taciturnaxolotl/doomacracy/linux/README.md

# Linux on doomacracy

A no-MMU Linux 6.8 (cnlohr's mini-rv32ima fork) with busybox in an
initramfs, configured for the DE1's 8 MB of SDRAM.

## Build (on a Linux machine)

```
cd linux
nix-build fhs.nix -o br-fhs      # NixOS only: a normal /usr layout for buildroot
./br-fhs/bin/br-fhs -c ./build.sh
```

The first build makes a cross toolchain and takes about an hour on two
cores. Copy `work/buildroot/output/images/Image` to `build/linux-Image`.

## Run in the emulator

```
make linux-emu            # 8 MB, the board's real size
```

## Changes from cnlohr's configs

- `CONFIG_RISCV_MISALIGNED=y`: our CPU traps on misaligned loads and stores
  (cnlohr's emulator quietly handles them), so the kernel has to fix them up.
- busybox: `FEATURE_PREFER_APPLETS` and `FEATURE_SH_STANDALONE`, so hush runs
  simple applets in-process; `vi` turned on; a few applets dropped (unzip,
  top, tree, lsof, checksums, xxd, and login/getty, which pulled in 83 KB of
  password code nothing here uses). No-MMU loads a private copy of busybox
  for every process, rounded up to a power of two, so its load size (text +
  data + bss + stack, from `flthdr`) has to stay under 512 KB; it is 430 KB.
- `patches/uclibc/0001-riscv32-no-64bit-syscall-arg-alignment.patch`: uClibc
  padded 64-bit syscall arguments ARM-style on riscv32, so `ftruncate`
  received a length of 0 and `vi` emptied every file it saved.
- `overlay/etc/inittab`: a respawning root shell on the serial console and
  one on the screen (`tty1`).
- Framebuffer console: `FB_SIMPLE`, `FRAMEBUFFER_CONSOLE`, `FONT_6x8`.
- Keyboard: `SERIO_ALTERA_PS2`, `KEYBOARD_ATKBD`, and the PLIC driver.
- `patches/linux/0001-altera_ps2-receive-only.patch`: the board's PS/2 port
  only receives, so the driver registers no write function; `atkbd` then
  skips probing the keyboard and treats it as plain set 2. The patch
  directory is listed after cnlohr's own (`board/qemu/riscv32-virt/nommu/
  patches`), which carries the rv32 no-MMU support; replacing it instead of
  adding to it builds a kernel whose `wait4` returns ENOSYS.
- The kernel's built-in device tree is not used; `tools/gen_dts.py` writes it.

## doomfetch

`doomfetch/doomfetch.c` is a small neofetch, compiled into the image by
`post-build.sh` and run from `/etc/profile` when a shell starts. It is C on
purpose: every process here loads its own copy of its program, so a 64 KB
binary is far cheaper than a script that runs busybox (430 KB) a dozen
times. For the same reason a pipe of two external busybox commands can run
out of memory; prefer shell builtins where you can.

Programs of your own are built the same way: the buildroot cross gcc with
`-fPIC -Wl,-elf2flt="-r -s STACK"`, and delete the `.gdb` file elf2flt
leaves next to the binary.

## doombench

`doombench` (`-q` for a quicker run) times a set of small tests and prints,
for each, the wall time, a rate, and the real cycles per instruction from
the CPU's own `cycle` and `instret` counters: integer ALU, multiply, divide,
`qsort`, reads and writes inside the D-cache (4K) and well beyond it (128K),
`memcpy`, load latency for a dependent pointer chase (cycles per hop,
including the loop), a system call, and starting a process. The last line
checks the cycle counter against the wall clock (it should read 50 MHz).
The table fits the 53x25 screen, since there is no pager.

In the emulator with `--timing --icache-bits 9 --dcache-bits 9` the same
table comes from the RTL cycle model, so the two can be compared row by row.
Measured on the DE1 (the cycle counter read 50.0 MHz) against the model:

| test | board ms | board rate | board CPI | model ms | model CPI |
| --- | --- | --- | --- | --- | --- |
| alu | 579 | 20.74 Mop/s | 1.43 | 573 | 1.42 |
| mul | 125 | 4.02 M/s | 2.44 | 123 | 2.41 |
| div | 161 | 1.24 M/s | 9.35 | 160 | 9.24 |
| qsort 1K | 177 | 69.24 Kel/s | 1.45 | 175 | 1.43 |
| read 4K | 152 | 52.57 MB/s | 1.30 | 152 | 1.30 |
| read 128K | 319 | 25.04 MB/s | 2.71 | 315 | 2.67 |
| write 4K | 178 | 45.05 MB/s | 2.37 | 174 | 2.31 |
| write 128K | 177 | 45.08 MB/s | 2.37 | 173 | 2.31 |
| memcpy 64K | 233 | 17.15 MB/s | 2.36 | 225 | 2.27 |
| lat 4K | 41 | 207 ns | 10.3 cyc | 41 | 10.3 cyc |
| lat 128K | 108 | 541 ns | 27.0 cyc | 119 | 29.7 cyc |
| syscall | 186 | 107.53 K/s | 1.83 | 184 | 1.81 |
| spawn | 108 | 73.96 /s | 4.33 | 94 | 3.41 |

Eleven of the thirteen rows agree within 4%. The two that do not are
`lat 128K` (the board is 9% faster) and `spawn` (the board is 27% slower).
The likely reason, not yet checked, is that both depend on where things land
in SDRAM: in `lat 128K` every load misses the cache, so the cost is which
rows happen to be open, and `spawn` depends on where the kernel finds room
for the new process.
