taciturnaxolotl/doomacracy/(commit log)

2026-11-11 feat: boot a no-MMU Linux to a shell on the soft CPU
    The CPU gains what Linux needs: control registers, traps and interrupts,
    machine and user mode, atomics and an instruction-cache flush. New
    devices add a timer, a 16550 serial console that also runs over the
    USB-Blaster, and power-off/reboot. The boot ROM can now load a Linux
    image (kernel plus device tree) from flash, and linux/ holds a buildroot
    recipe for a kernel and busybox that fit in the DE1's 8 MB. Doom is
    unchanged and still matches its reference trace.
    💘 Generated with Crush
    Assisted-by: Crush:claude-opus-5-5
    [boot.c, cpu.vhd, dcache.vhd, doomacracy.vhd, doomacracy_emu.c]
2026-11-11 feat: show the Linux console on the VGA monitor
    The video hardware gains a 16-bit colour mode, which Linux's simple
    framebuffer driver needs. The boot ROM switches to it before starting the
    kernel, and the kernel now runs a text console and a shell on the screen
    alongside the serial console. Doom still uses the 256-colour mode and is
    unaffected.
    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
2026-11-11 feat: type into Linux on the board's PS/2 keyboard
    Adds a PS/2 receive port that Linux's existing Altera PS/2 driver can
    use and a minimal standard interrupt controller to deliver its
    interrupts, so the shell on the VGA console takes keyboard input and
    the board works without a PC. The keyboard port can't send commands,
    so a small kernel patch makes the driver skip probing the keyboard.
    Doom is unchanged.
    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
    [cpu.vhd, doomacracy.vhd, doomacracy_emu.c, io.vhd, tb_cpu.vhd]
2026-11-12 feat: add the vi text editor to Linux on the board
    Busybox's vi is now included, and it saves files correctly: uClibc
    passed 64-bit system call arguments with ARM-style padding on 32-bit
    RISC-V, so the kernel saw a length of zero and every save emptied the
    file. A uClibc patch fixes that for all such calls. Busybox drops its
    unused login and getty to stay small enough for the 8 MB of memory, and
    the emulator no longer drops scripted keystrokes when idle time jumps.
    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
    [doomacracy_emu.c]
2026-11-12 feat: add doomfetch, a neofetch for the board
    A small C program shows a skull, the hardware, kernel, uptime, memory
    and a colour bar whenever a shell starts, sized for the 53-column screen
    console. It is built into the Linux image during the buildroot build and
    kept tiny because every process on this machine loads its own copy of
    its program.
    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
2026-11-12 perf: keep SDRAM rows open between accesses
    The SDRAM controller used to open a row, read or write, and close it
    again for every access. It now leaves one row open per bank, so accesses
    to a row that is already open skip that overhead and writes finish as
    soon as their data is out. By the emulator's cycle model this makes
    Linux about 25% faster and Doom about 3%. The simulated SDRAM chip now
    checks per-bank row timing, so a timing mistake in the controller fails
    the tests.
    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
    [doomacracy_emu.c, models.vhd, sdram_ctrl.vhd]
2026-11-13 fix: stop KEY0 resets from corrupting SDRAM
    Since SDRAM rows stay open between accesses, pressing KEY0 reset the
    controller's record of open rows but left them open in the chip. After
    that, refreshes and row opens were refused, so data in SDRAM could be
    lost or written to the wrong place. The flash loader buffers images in
    SDRAM, so loads started with KEY0 sometimes wrote garbage to flash and
    the board then failed to boot, while a full power cycle worked. The
    controller now closes every bank after a reset, a new simulation test
    presses KEY0 in the middle of an SDRAM test, and the loader re-reads
    its buffer before writing flash so memory faults stop the load.
    Assis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
    [boot.c, sdram_ctrl.vhd, tb_soc.vhd]
2026-11-13 feat: add doombench to measure the board from inside Linux
    A small benchmark times integer, multiply and divide work, sorting,
    cached and uncached memory reads and writes, memcpy, load latency,
    system calls and process start-up, and reports real cycles per
    instruction from the CPU's own counters. Its table fits the 53x25 screen
    console, so results can be read on the board and compared with the
    emulator's cycle model. Busybox also gains the clear command.
    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
2026-11-13 build: time the SDRAM, SRAM and flash pins in TimeQuest
    The timing constraints only covered logic inside the FPGA; the memory
    pins were unconstrained, so a change that broke them would have shown
    up as a mystery on the board. The constraints now describe the SDRAM,
    SRAM and flash chips from their datasheets, so TimeQuest checks the
    full path out to each chip and back.
    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
2026-11-13 build: use the TimeQuest timing analyzer by default
    Quartus 8.1 defaults to the classic timing analyzer, which ignores the
    project's timing constraints file, so the new pin constraints were only
    checked if TimeQuest was switched on by hand.
    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
2026-11-13 perf: pipeline the CPU, about 1.6x fewer cycles per instruction
    The multicycle core spent at least two cycles on every instruction, and
    three on loads and stores, which was what held Doom back. It is now a
    five stage pipeline with forwarding, static branch prediction and a
    return stack, so most instructions finish in one cycle. The instruction
    cache prefetches the next line and the data cache buffers up to four
    stores, so bursts of writes no longer stall.
    In simulation Linux boots about 1.35x faster and Doom starts about 1.4x
    faster; the emulator's cycle model, updated to match, puts the timedemo
    at CPI 2.0 instead of 3.2. The design keeps stalls and operand values
    off every RAM address so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
    [cpu.vhd, dcache.vhd, doomacracy.vhd, doomacracy_emu.c, icache.vhd, tb_cpu.vhd]
2026-11-13 feat: fill the whole screen by switching to 640x400 at 70 Hz
    The picture used to sit in the middle of a 640x480 frame with black
    bars above and below. The board now outputs the VGA mode DOS Doom ran
    in, so the monitor stretches the same 320x200 framebuffer over its full
    4:3 screen, which is the shape the game's art was drawn for. Nothing
    changes for software or memory use.
    The frame counter now ticks at 69.6 Hz, and the emulator follows, so
    key scripts timed in frames play slightly faster. The simulation frame
    grabber captures the new 640x400 picture.
    Assisted-by: Crush:claude-fable-5-2
    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
2026-11-13 docs: add a hardware reference manual with diagrams
    The spec lists registers and addresses but does not show how the
    machine works. This adds a 43 page manual that walks through the
    instruction set, the pipeline, the ALU, multiply and divide, traps,
    the caches and memory controllers, video, the I/O devices and the boot
    sequence, with block diagrams, state machines, K-maps, timing diagrams
    and a full block diagram of the CPU and system on one page.
    `make book` builds the PDF from LaTeX. The PDF itself is not tracked.
    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
2026-11-14 feat: add CoreMark as a second firmware to benchmark the CPU
    CoreMark gives a standard number to compare this CPU with others. The
    new firmware runs it from SRAM, once with the performance seeds and
    once with the validation seeds, and prints the cycles and instructions
    of each timed run. The benchmark sources are fetched from EEMBC at a
    pinned commit and compiled unchanged.
    `make coremark-emu` scores it in the emulator's cycle model (121.6, or
    2.43 CoreMark/MHz) and `make coremark-sim` runs a short pass in the RTL
    simulation, which matches the model to within 1.4%. `make coremark`
    builds a flash image to load on the board.
    The idea comes from builderdev212's ai-fpga-sdp Nios V port.
    💘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
2026-11-14 docs: record board benchmark results and refresh the README
    doombench on the DE1 matches the emulator's cycle model within 4% on
    11 of 13 tests, so the model's speed figures can be trusted. The
    benchmark table in the Linux README was from the old multicycle CPU;
    it now shows the board and the model side by side, and the manual has
    the same comparison.
    The README now says the board boots Linux too, lists the docs, explains
    how to run Linux and CoreMark on the board, and uses plain
    `nix develop`, because the `path:` form copies the multi-gigabyte build
    directory into the nix store on every call.
    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
